ODZ-UJF-AV-CR/SPACEDOS02_ANTARCTICA/doc/src/img/SPACEDOS02A_bottom.jpg

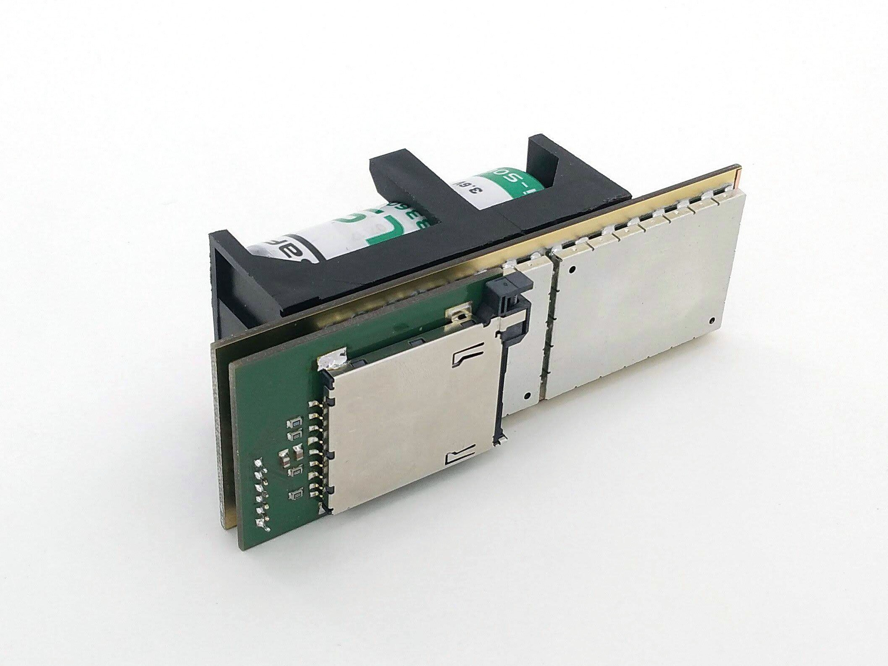
doc/src/img/SPACEDOS02A_bottom.jpg
