ODZ-UJF-AV-CR/SPACEDOS02_ANTARCTICA/doc/src/img/ISS_radiation_map.png

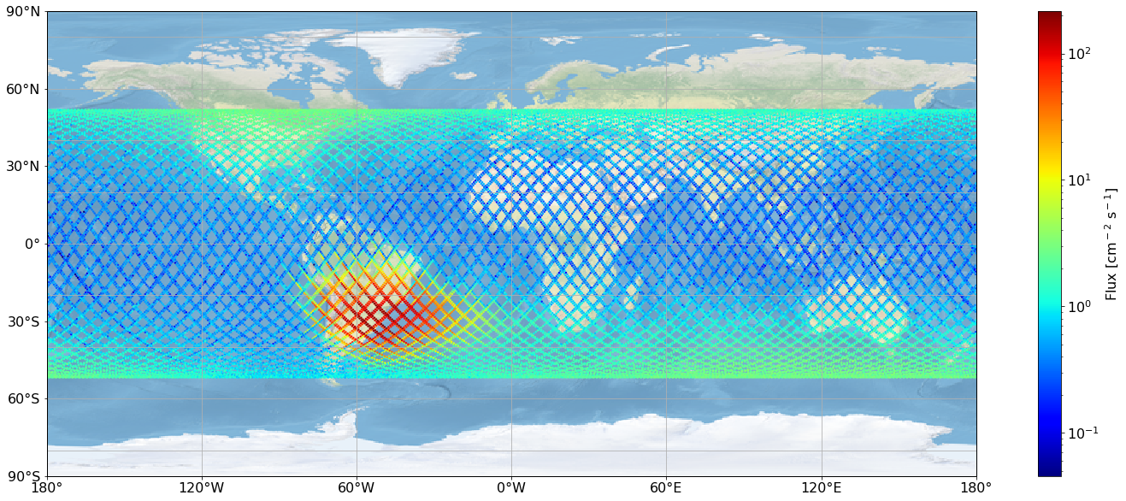
doc/src/img/ISS_radiation_map.png
