ODZ-UJF-AV-CR/SPACEDOS02_ANTARCTICA/README.md

# SPACEDOS02_ANTARCTICA
SPACEDOS for Antarctica station
