ODZ-UJF-AV-CR/SPACEDOS02_ANTARCTICA/doc/src/img/iss_flight_spectra.png

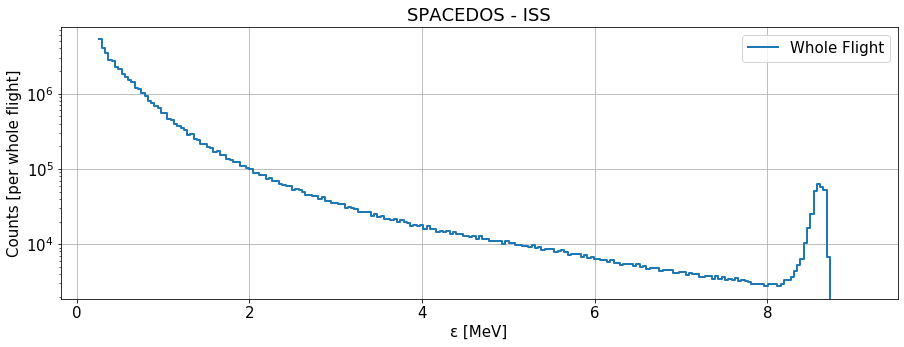
doc/src/img/iss_flight_spectra.png
