ODZ-UJF-AV-CR/SPACEDOS02_ANTARCTICA/doc/src/img/SPACEDOS02A_top.jpg

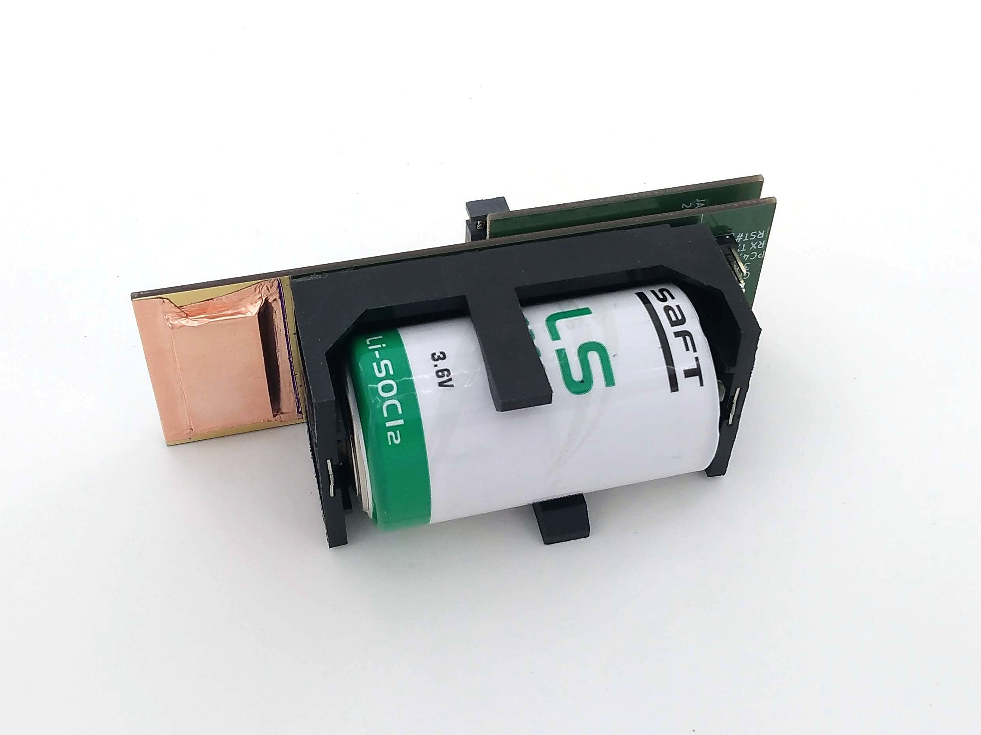
doc/src/img/SPACEDOS02A_top.jpg
