ODZ-UJF-AV-CR/SPACEDOS02_ANTARCTICA/hw/CAD/SPACEDOS02A_BASEBOX03A/cad/amf/SPACEDOS02A_BASEBOX03A.stl

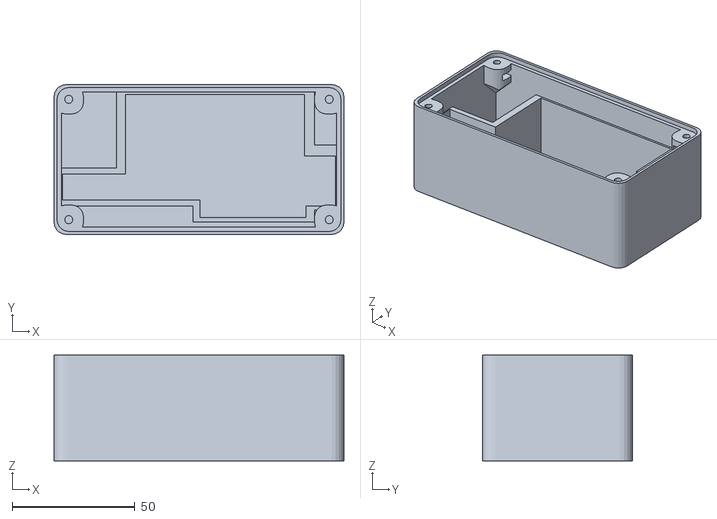
[picture p5: CAD file, 2024-12-14]
hw/CAD/SPACEDOS02A_BASEBOX03A/cad/amf/SPACEDOS02A_BASEBOX03A.stl
118.0 x 61.0 x 43.1
