ODZ-UJF-AV-CR/SPACEDOS02_ANTARCTICA/hw/CAD/SPACEDOS02A_CAD01A/amf/SPACEDOS02A_CAD01A.stl

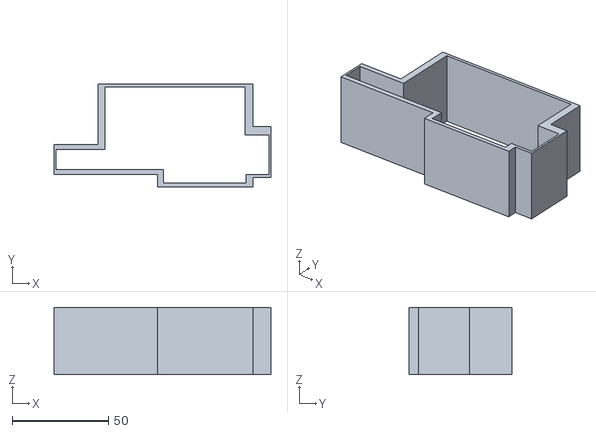
[picture p6: CAD file, 2024-12-14]
hw/CAD/SPACEDOS02A_CAD01A/amf/SPACEDOS02A_CAD01A.stl
113.0 x 53.5 x 35.0
