ODZ-UJF-AV-CR/SPACEDOS02_ANTARCTICA/hw/CAD/SPACEDOS02A_BASEBOX03A/cad/amf/SPACEDOS02A_BASEBOX03A_PLBASE_top.stl

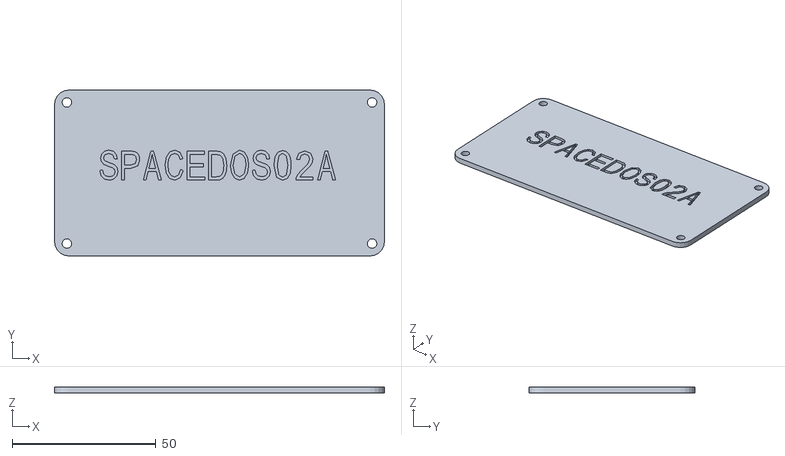
[picture p7: CAD file, 2024-12-14]
hw/CAD/SPACEDOS02A_BASEBOX03A/cad/amf/SPACEDOS02A_BASEBOX03A_PLBASE_top.stl
114.6 x 57.6 x 2.10
