ODZ-UJF-AV-CR/SPACEDOS02_ANTARCTICA/(list of files, cad)

Other CAD files:
hw/CAD/SPACEDOS02A_BASEBOX03A/cad/src/text/Letters.dxf
hw/CAD/SPACEDOS02A_BASEBOX03A/cad/configuration.scad
hw/CAD/SPACEDOS02A_BASEBOX03A/cad/assembly.scad
hw/CAD/SPACEDOS02A_BASEBOX03A/cad/print_data/SPACEDOS02A_BASEBOX03A.scad
hw/CAD/SPACEDOS02A_BASEBOX03A/cad/src/MLAB_logo.scad
hw/CAD/SPACEDOS02A_BASEBOX03A/cad/src/bocnice.scad
hw/CAD/SPACEDOS02A_BASEBOX03A/cad/src/dno.scad
hw/CAD/SPACEDOS02A_BASEBOX03A/cad/src/manufactury_conf.scad
hw/CAD/SPACEDOS02A_BASEBOX03A/cad/src/otvory.scad
hw/CAD/SPACEDOS02A_BASEBOX03A/cad/src/otvory_conf.scad
hw/CAD/SPACEDOS02A_BASEBOX03A/cad/src/plbase.scad
hw/CAD/SPACEDOS02A_BASEBOX03A/cad/src/produkt_logo.scad
hw/CAD/SPACEDOS02A_BASEBOX03A/cad/src/sloupek.scad
hw/CAD/SPACEDOS02A_BASEBOX03A/cad/src/spodni_kryt.scad
hw/CAD/SPACEDOS02A_BASEBOX03A/cad/src/text/Write.scad
hw/CAD/SPACEDOS02A_CAD01A/print_data/P_SPACEDOS02A_CAD01A.scad
