ODZ-UJF-AV-CR/SPACEDOS02_ANTARCTICA/hw/sch_pcb/SPACEDOS02A_PCB01A/SPACEDOS02A_PCB01A.kicad_pcb

## KiCad design hw/sch_pcb/SPACEDOS02A_PCB01A/SPACEDOS02A_PCB01A.kicad_pcb (2024-12-14)

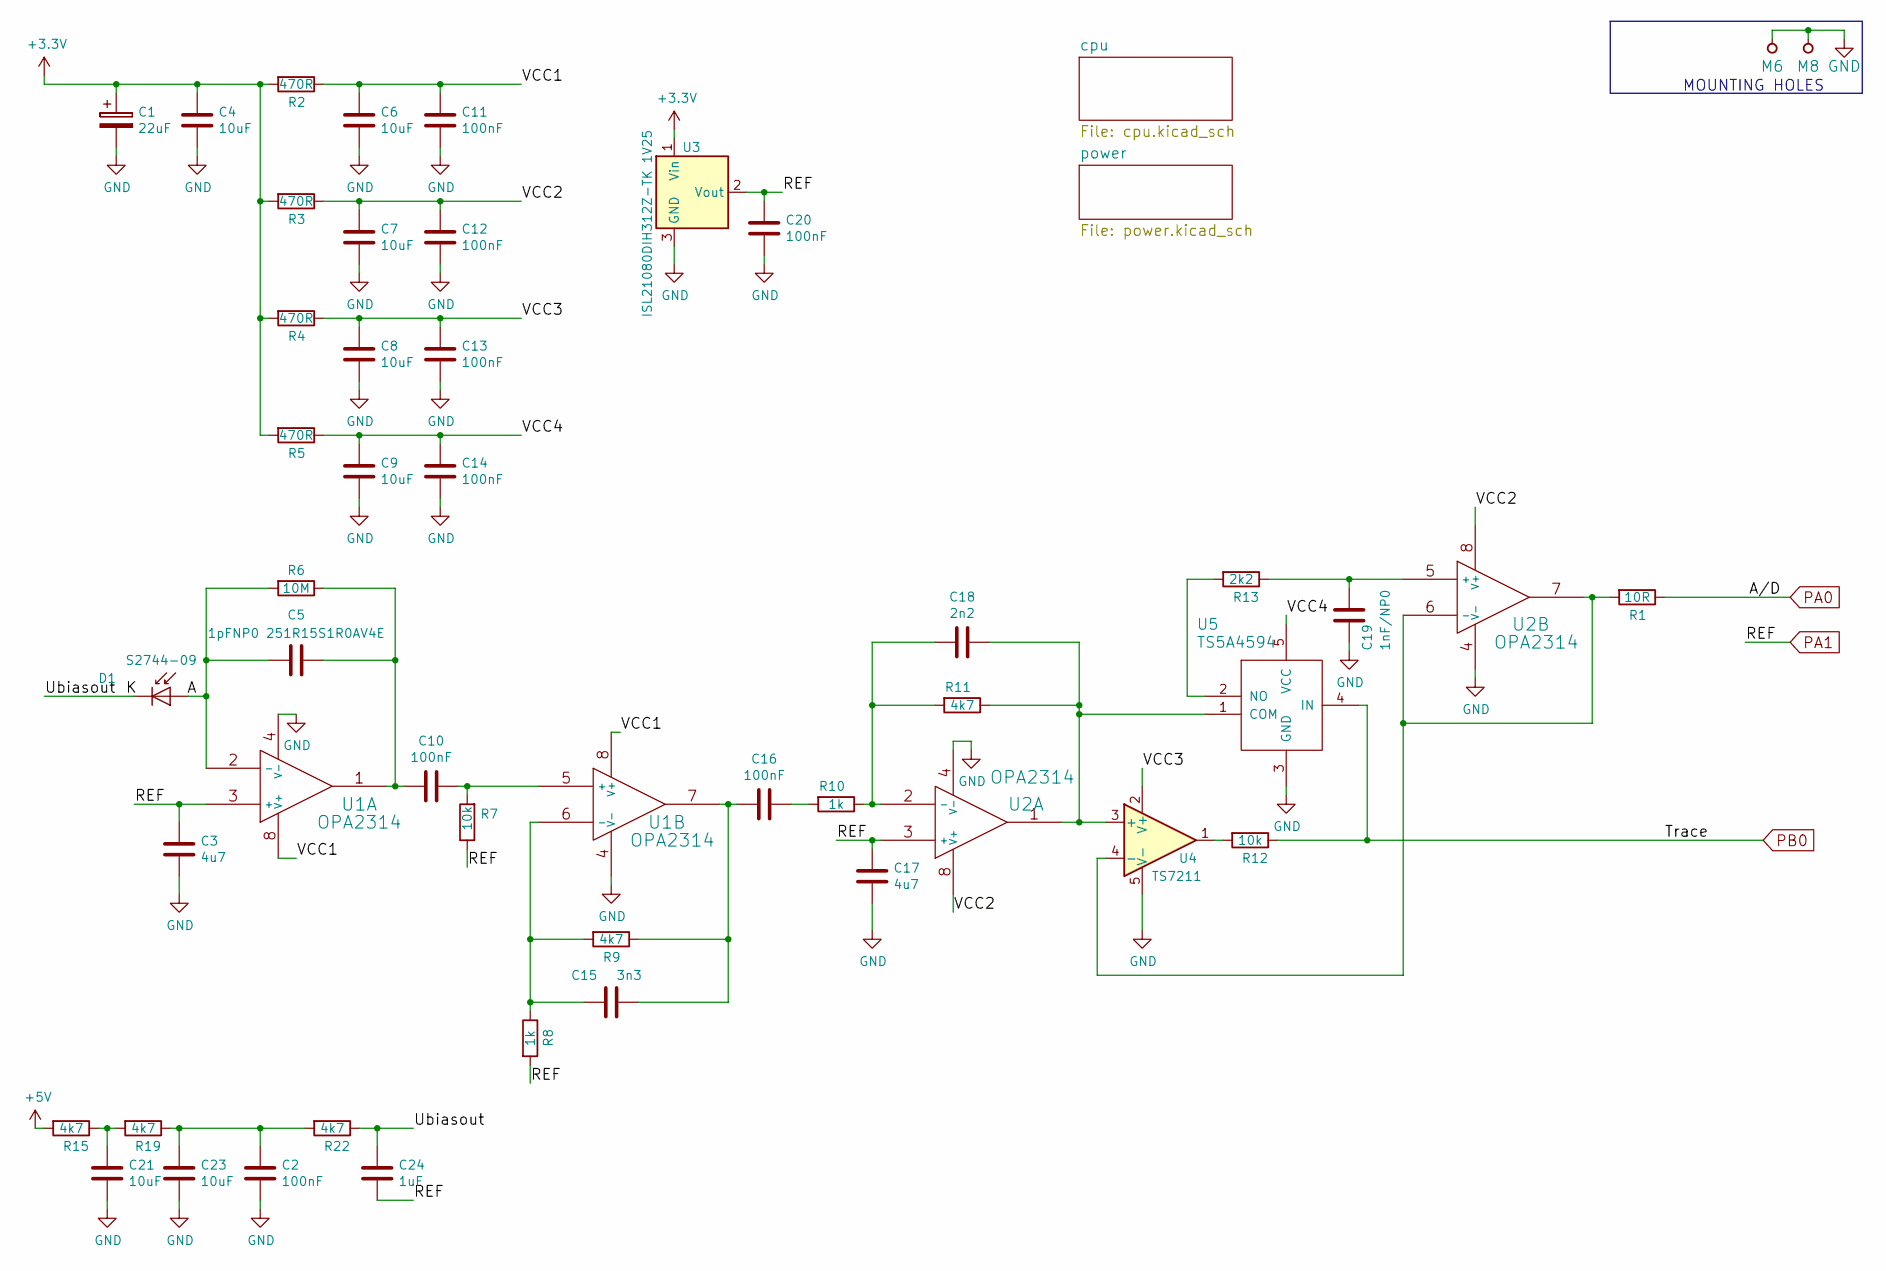
[picture p8: schematic SPACEDOS02A_PCB01A.kicad_sch, SPACEDOS02A]

Parts:
C1: 22uF; TantalC_SizeC_Reflow
C2, C10, C11, C12, C13, C14, C16, C20: 100nF; SMD-0805
C3, C17: 4u7; SMD-0805
C4, C6, C7, C8, C9, C21, C23: 10uF; SMD-0805
C5: 1pFNP0 251R15S1R0AV4E; SMD-0805
C15: 3n3; SMD-0805
C18: 2n2; SMD-0805
C19: 1nF/NP0; SMD-0805
C24: 1uF; SMD-0805
D1: S2744-09; HAMAMATSU_S2744-09
M6: BMI-S-210-F
M8: BMI-S-210-F; Laird_Technologies_BMI-S-210-F_44.00x30.50mm
R1: 10R; SMD-0805
R2, R3, R4, R5: 470R; SMD-0805
R6: 10M; SMD-0805
R7, R12: 10k; SMD-0805
R8, R10: 1k; SMD-0805
R9, R11, R15, R19, R22: 4k7; SMD-0805
R13: 2k2; SMD-0805
U1, U2: OPA2314; SOIC-8_3.9x4.9mm_Pitch1.27mm
U3: ISL21080DIH312Z-TK 1V25; SOT-23
U4: TS7211; SOT-23-5_HandSoldering
U5: TS5A4594; SOT-23-5_HandSoldering

Connections:
+3V3: C1.1, C4.1, R2.2, R3.2, R4.2, R5.2, U3.1 (Vin); also elsewhere on the board
+5V: R15.2; also elsewhere on the board
/A: C5.2, D1.2 (A), R6.2, U1.2 (-)
/K: C24.1, D1.1 (K), R22.1
/VCC1: C6.1, C11.1, R2.1, U1.8 (V+)
/VCC2: C7.1, C12.1, R3.1, U2.8 (V+)
/VCC3: C8.1, C13.1, R4.1, U4.2 (V+)
/VCC4: C9.1, C14.1, R5.1, U5.5 (VCC)
GND: C1.2, C2.2, C3.2, C4.2, C6.2, C7.2, C8.2, C9.2, C11.2, C12.2, C13.2, C14.2, C17.2, C19.2, C20.2, C21.2, C23.2, M6.1, M8.1, U1.4 (V-), U2.4 (V-), U3.3 (GND), U4.5 (V-), U5.3 (GND); also elsewhere on the board
unnamed: C2.1, C23.1, R19.1, R22.2
unnamed: C10.1, R7.2, U1.5 (+)
unnamed: C5.1, C10.2, R6.1, U1.1
unnamed: C15.1, C16.2, R9.1, U1.7
unnamed: C15.2, R8.1, R9.2, U1.6 (-)
unnamed: C16.1, R10.2
unnamed: C18.1, R11.1, U2.1, U4.3 (+), U5.1 (COM)
unnamed: C18.2, R10.1, R11.2, U2.2 (-)
unnamed: C19.1, R13.1, U2.5 (+)
unnamed: C21.1, R15.1, R19.2
unnamed: R1.2, U2.6 (-), U2.7, U4.4 (-)
unnamed: R12.2, U4.1
unnamed: R13.2, U5.2 (NO)
PA0: R1.1; also elsewhere on the board
PA1: C3.1, C17.1, C20.1, C24.2, R7.1, R8.2, U1.3 (+), U2.3 (+), U3.2 (Vout); also elsewhere on the board
PB0: R12.1, U5.4 (IN); also elsewhere on the board

Notes on the sheet:
MOUNTING HOLES

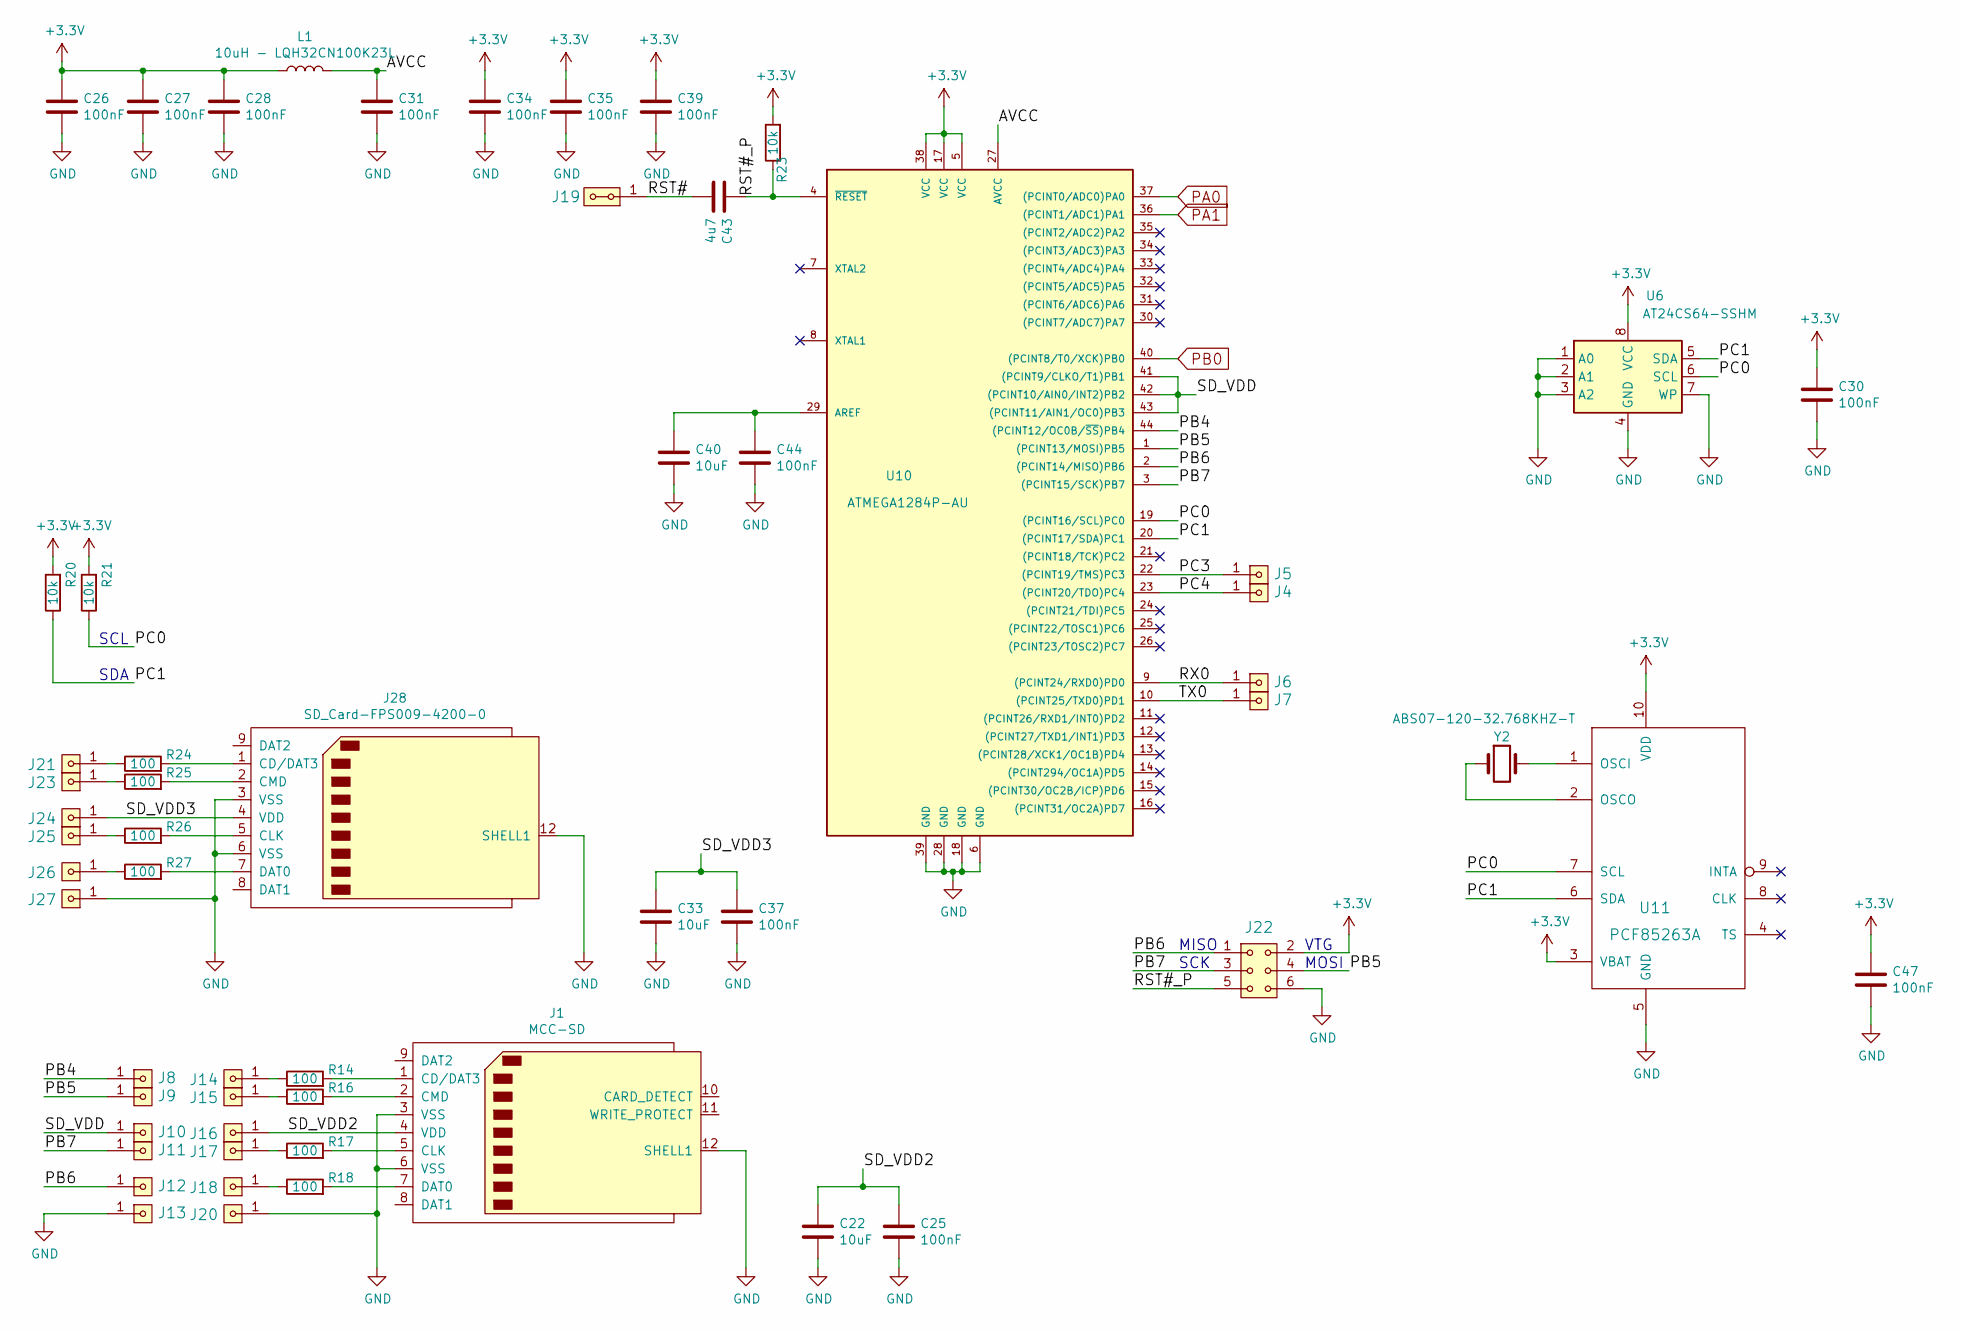
[picture p9: schematic cpu.kicad_sch]

Parts:
C22, C33, C40: 10uF; SMD-0805
C25, C26, C27, C28, C30, C31, C34, C35, C37, C39, C44, C47: 100nF; SMD-0805
C43: 4u7; SMD-0805
J1: MCC-SD
J4, J5, J6, J7, J8, J9, J10, J11, J12, J13, J14, J15, J16, J17, J18, J20, J21, J23, J24, J25, J26, J27: HEADER_1x01; Straight_1x01
J19: HEADER_2x01_PARALLEL; Straight_2x01
J22: HEADER_2x03; SMD_2x03
J28: SD_Card-FPS009-4200-0; FPS009-4200-0
L1: 10uH - LQH32CN100K23L; SMD-1210
R14, R16, R17, R18, R24, R25, R26, R27: 100; SMD-0805
R20, R21, R23: 10k; SMD-0805
U6: AT24CS64-SSHM; SOIC-8_3.9x4.9mm_P1.27mm
U10: ATMEGA1284P-AU; TQFP-44_10x10mm_P0.8mm
U11: PCF85263A; TSSOP-10_3x3mm_Pitch0.5mm
Y2: ABS07-120-32.768KHZ-T; ABS07

Connections:
+3V3: C26.1, C27.1, C28.1, C30.1, C34.1, C35.1, C39.1, C47.1, J22.2, L1.1, R20.2, R21.2, R23.2, U6.8 (VCC), U10.5 (VCC), U10.17 (VCC), U10.38 (VCC), U11.3 (VBAT), U11.10 (VDD); also elsewhere on the board
/cpu/AVCC: C31.1, L1.2, U10.27 (AVCC)
/cpu/PB4: J8.1, U10.44 ((PCINT12/OC0B/~SS)PB4)
/cpu/PB5: J9.1, J22.4, U10.1 ((PCINT13/MOSI)PB5)
/cpu/PB6: J12.1, J22.1, U10.2 ((PCINT14/MISO)PB6)
/cpu/PB7: J11.1, J22.3, U10.3 ((PCINT15/SCK)PB7)
/cpu/PC0: R21.1, U6.6 (SCL), U10.19 ((PCINT16/SCL)PC0), U11.7 (SCL)
/cpu/PC1: R20.1, U6.5 (SDA), U10.20 ((PCINT17/SDA)PC1), U11.6 (SDA)
/cpu/PC3: J5.1, U10.22 ((PCINT19/TMS)PC3)
/cpu/PC4: J4.1, U10.23 ((PCINT20/TDO)PC4)
/cpu/RST#: C43.2, J19.1, J19.2
/cpu/RST#_P: C43.1, J22.5, R23.1, U10.4 (~RESET)
/cpu/RX0: J6.1, U10.9 ((PCINT24/RXD0)PD0)
/cpu/SD_VDD: J10.1, U10.41 ((PCINT9/CLKO/T1)PB1), U10.42 ((PCINT10/AIN0/INT2)PB2), U10.43 ((PCINT11/AIN1/OC0)PB3)
/cpu/SD_VDD2: C22.1, C25.1, J1.4 (VDD), J16.1
/cpu/SD_VDD3: C33.1, C37.1, J24.1, J28.4 (VDD)
/cpu/TX0: J7.1, U10.10 ((PCINT25/TXD0)PD1)
GND: C22.2, C25.2, C26.2, C27.2, C28.2, C30.2, C31.2, C33.2, C34.2, C35.2, C37.2, C39.2, C40.2, C44.2, C47.2, J1.3 (VSS), J1.6 (VSS), J1.12 (SHELL1), J13.1, J20.1, J22.6, J27.1, J28.3 (VSS), J28.6 (VSS), J28.12 (SHELL1), U6.1 (A0), U6.2 (A1), U6.3 (A2), U6.4 (GND), U6.7 (WP), U10.6 (GND), U10.18 (GND), U10.28 (GND), U10.39 (GND), U11.5 (GND); also elsewhere on the board
unnamed: C40.1, C44.1, U10.29 (AREF)
unnamed: J1.1 (CD/DAT3), R14.2
unnamed: J1.2 (CMD), R16.2
unnamed: J1.5 (CLK), R17.2
unnamed: J1.7 (DAT0), R18.2
unnamed: J14.1, R14.1
unnamed: J15.1, R16.1
unnamed: J17.1, R17.1
unnamed: J18.1, R18.1
unnamed: J21.1, R24.1
unnamed: J23.1, R25.1
unnamed: J25.1, R26.1
unnamed: J26.1, R27.1
unnamed: J28.1 (CD/DAT3), R24.2
unnamed: J28.2 (CMD), R25.2
unnamed: J28.5 (CLK), R26.2
unnamed: J28.7 (DAT0), R27.2
unnamed: U11.1 (OSCI), Y2.2
unnamed: U11.2 (OSCO), Y2.1
PA0: U10.37 ((PCINT0/ADC0)PA0); also elsewhere on the board
PA1: U10.36 ((PCINT1/ADC1)PA1); also elsewhere on the board
PB0: U10.40 ((PCINT8/T0/XCK)PB0); also elsewhere on the board

Notes on the sheet:
MOSI
SCK
MISO
VTG
SDA
SCL

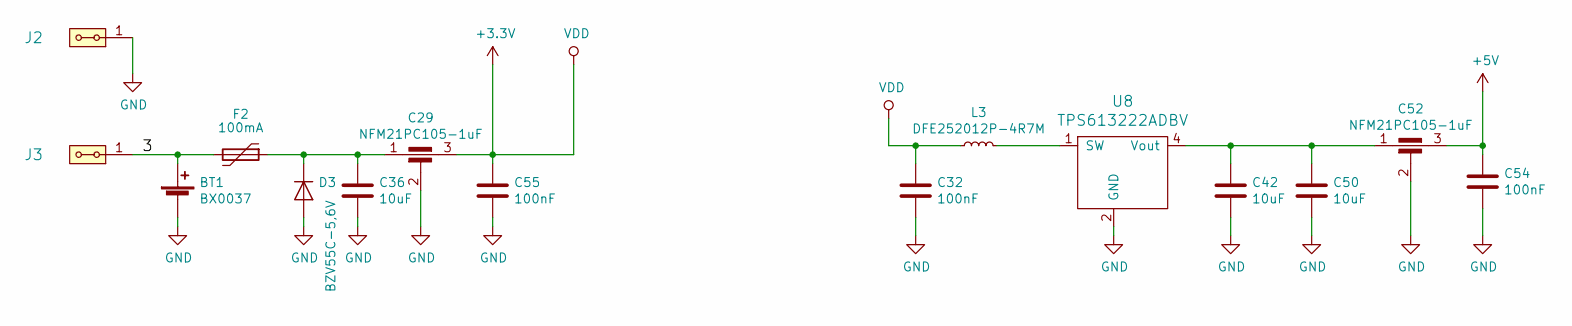
[picture p10: schematic power.kicad_sch]

Parts:
BT1: BX0037; BX0037_nez_sroubu
C29, C52: NFM21PC105-1uF; FIR_0805
C32, C54, C55: 100nF; SMD-0805
C36, C42, C50: 10uF; SMD-0805
D3: BZV55C-5,6V; D_MiniMELF
F2: 100mA; SMD-0805
J2, J3: HEADER_2x01_PARALLEL; Straight_1x02
L3: DFE252012P-4R7M; R_0805_2012Metric_Pad1.15x1.40mm_HandSolder
U8: TPS613222ADBV; SOT-23-5

Connections:
+3V3: C29.3, C32.1, C55.1, L3.1; also elsewhere on the board
+5V: C52.3, C54.1; also elsewhere on the board
/power/3: BT1.1 (+), F2.2, J3.1, J3.2
GND: BT1.2 (-), C29.2, C32.2, C36.2, C42.2, C50.2, C52.2, C54.2, C55.2, D3.2 (A), J2.1, J2.2, U8.2 (GND); also elsewhere on the board
unnamed: C29.1, C36.1, D3.1 (K), F2.1
unnamed: C42.1, C50.1, C52.1, U8.4 (Vout)
unnamed: L3.2, U8.1 (SW)

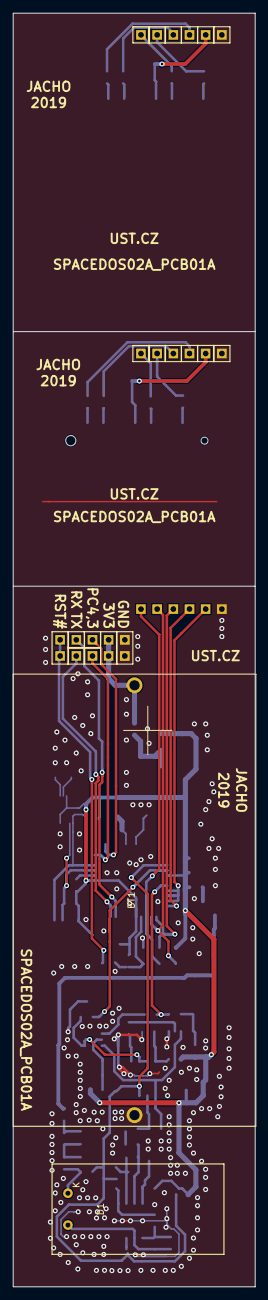
[picture p11: board SPACEDOS02A_PCB01A.kicad_pcb from above]

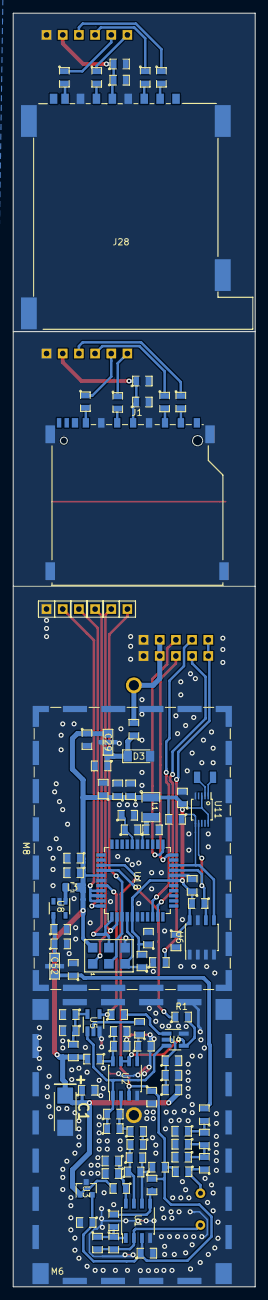
[picture p12: board SPACEDOS02A_PCB01A.kicad_pcb from below]

Board: 2 copper layers, 38.0 x 200.0 mm, 120 parts (99 on the bottom side), 64 nets.
