ODZ-UJF-AV-CR/SPACEDOS02_ANTARCTICA/(notices)

Notices in the files:
hw/sch_pcb/SPACEDOS02A_PCB01A/SPACEDOS02A_PCB01A.kicad_sch:
GPL 3
